dnalepa04/Pour-Pal/README.md

Hello! This is a repository for a project my friends (Adam Slamani & Carter Hill) and I worked on in our Microcontrollers class. I suggest looking at the presentation PDF to get a better understanding of the project overview! If you would like a more in depth overview please look at the report written for this project.

Access_Point
This is the final release of the code that is fully commeneted and ready for use with the drink dispenser

access_point_v1
This version for the code was the initial draft of the website

access_point_v2
This version added the motor driver functionality

access_point_v3
This version added the dispensing functionality and custom cocktails

access_point_v4
This version added the true flow rate for the pumps

access_point_v5
This version added a feature to expell all of the water out of the tubes after it is done.

access_point_v6
This version added flash functionality so that the custom cocktails would be saved after the system is powered off.

wifi_connect_ESP32_enterpirse
This was a code that allowed the ESP32 to connect to the UVM WiFi
