dnalepa04/Pour-Pal/Pour Pal Presi.pdf

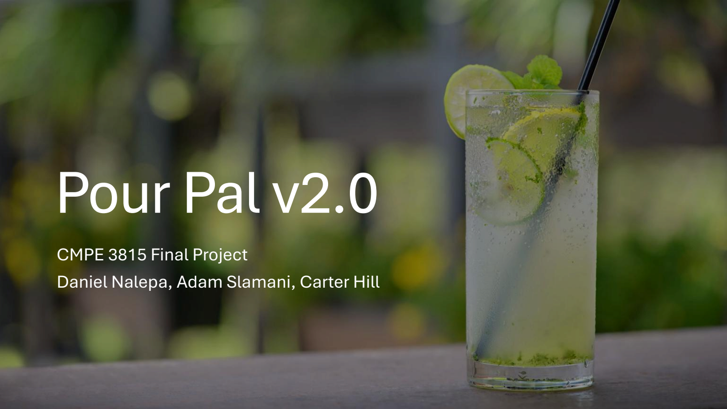
[picture p16: page 1]

# Pour Pal v2.0

### CMPE 3815 Final Project Daniel Nalepa, Adam Slamani, Carter Hill

# Agenda

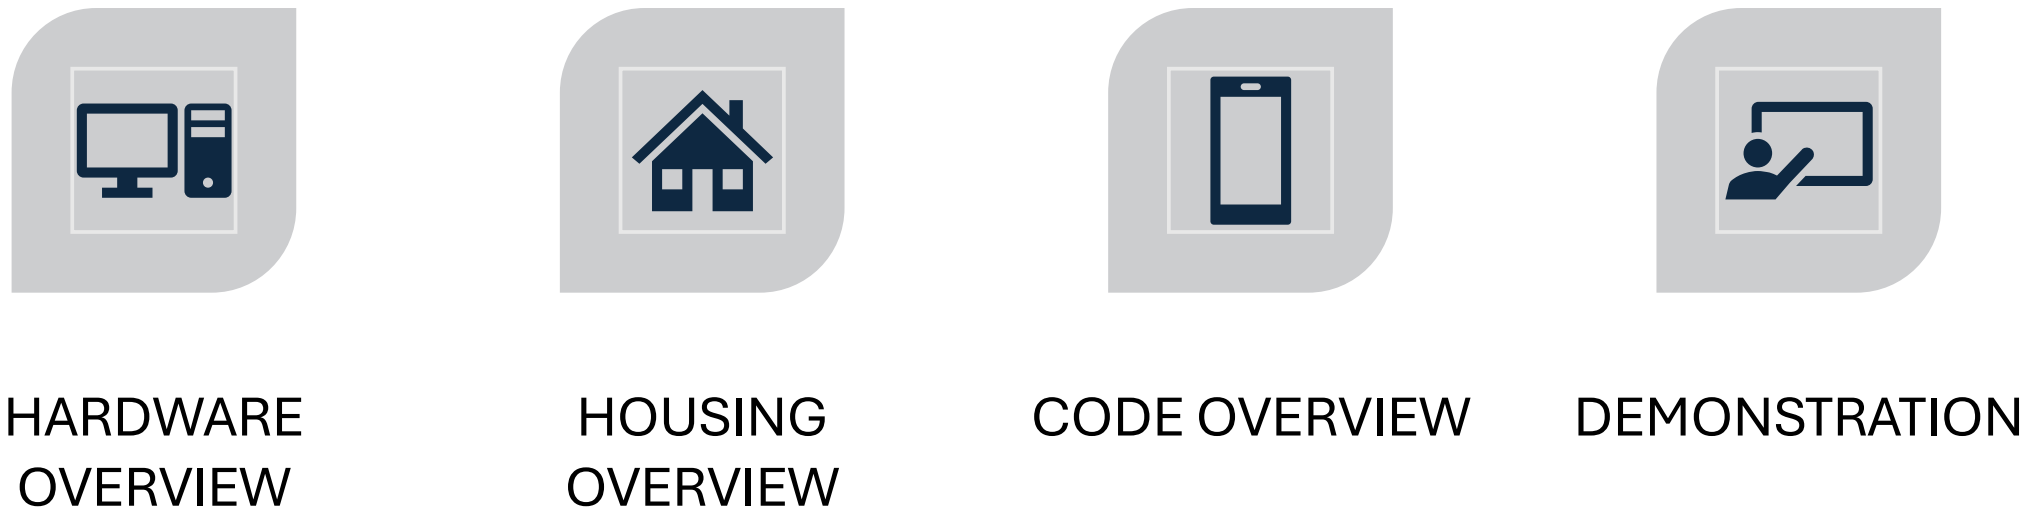
[picture p17: figure]
HARDWARE OVERVIEW; HOUSING OVERVIEW; CODE OVERVIEW; DEMONSTRATION
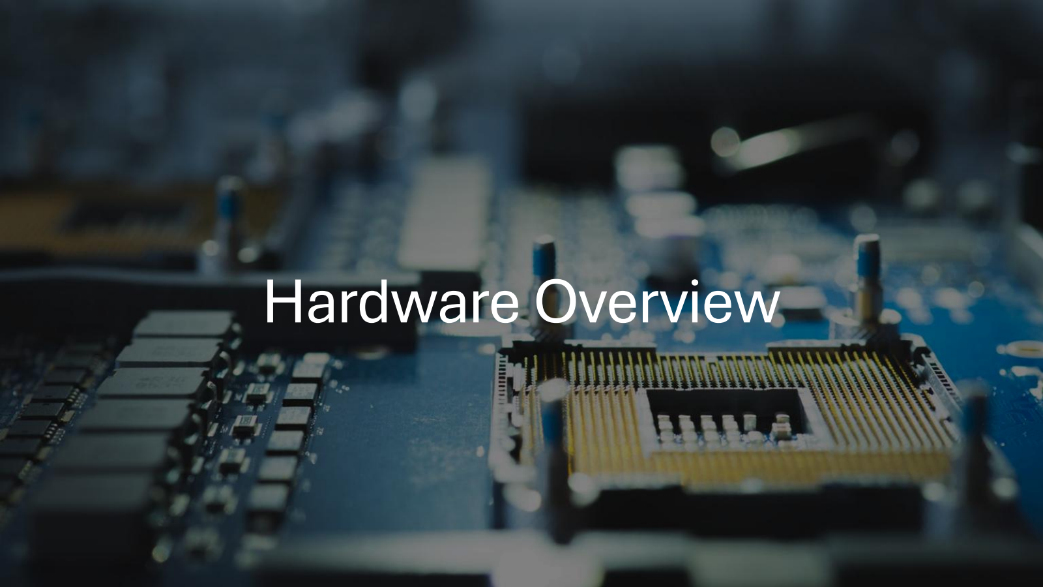
[picture p18: page 3]

# Hardware Overview

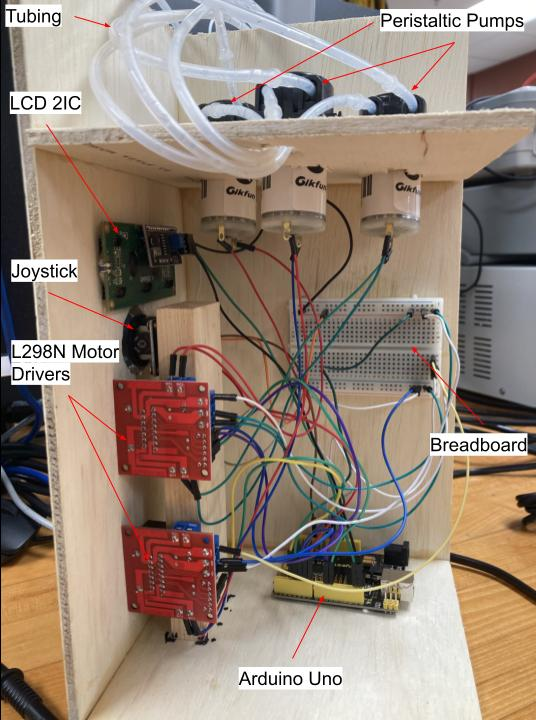
[picture p19: figure]

# Previous Design

Limitations
- Only three 100 ml/min pumps
- Motors not at 12VDC so slower than 100 ml
- Joystick controls everything
- Exposed Components
- Ugly housing and prone to spillage

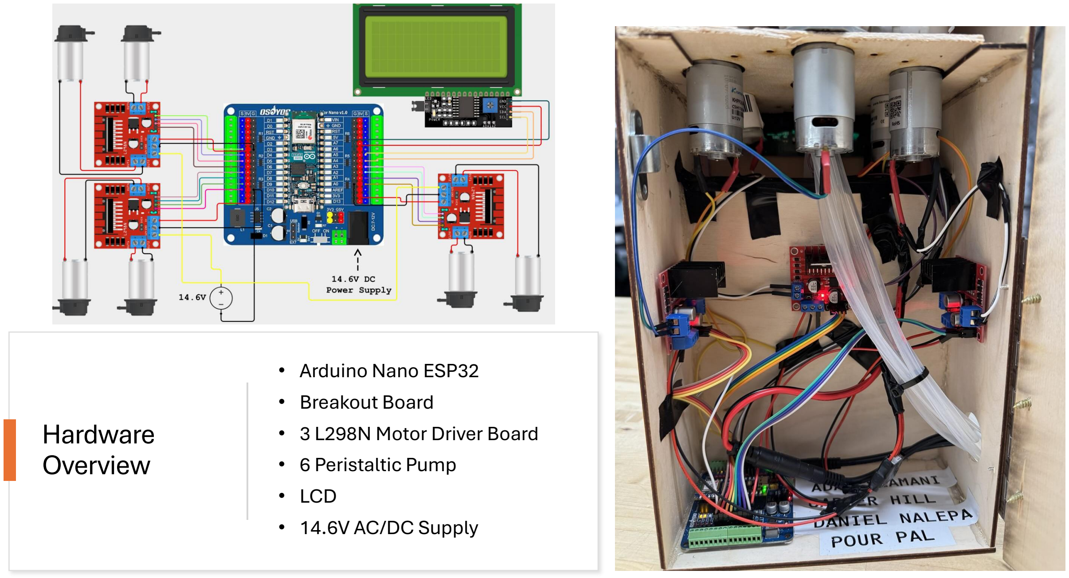
[picture p20: page 5]

### Hardware Overview

- Arduino Nano ESP32
- Breakout Board
- 3 L298N Motor Driver Board
- 6 Peristaltic Pump
- LCD
- 14.6V AC/DC Supply

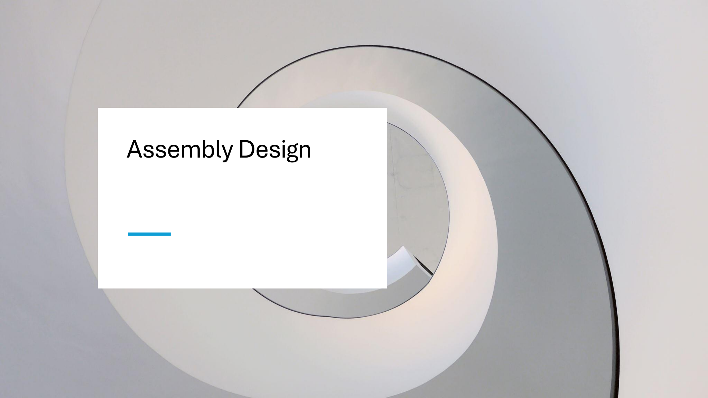
[picture p21: page 6]

# Assembly Design

## Housing Overview

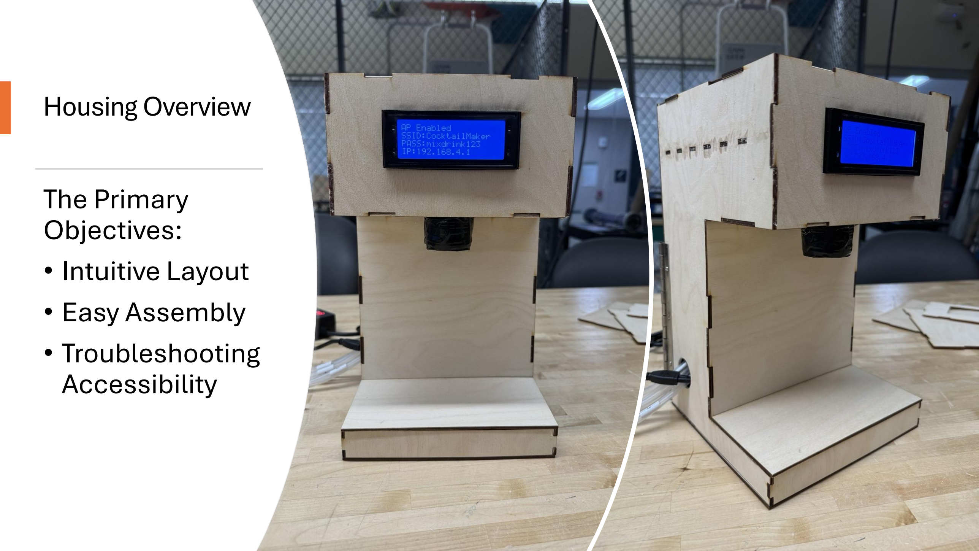
[picture p22: page 7]

## The Primary Objectives: - Intuitive Layout - Easy Assembly - Troubleshooting Accessibility

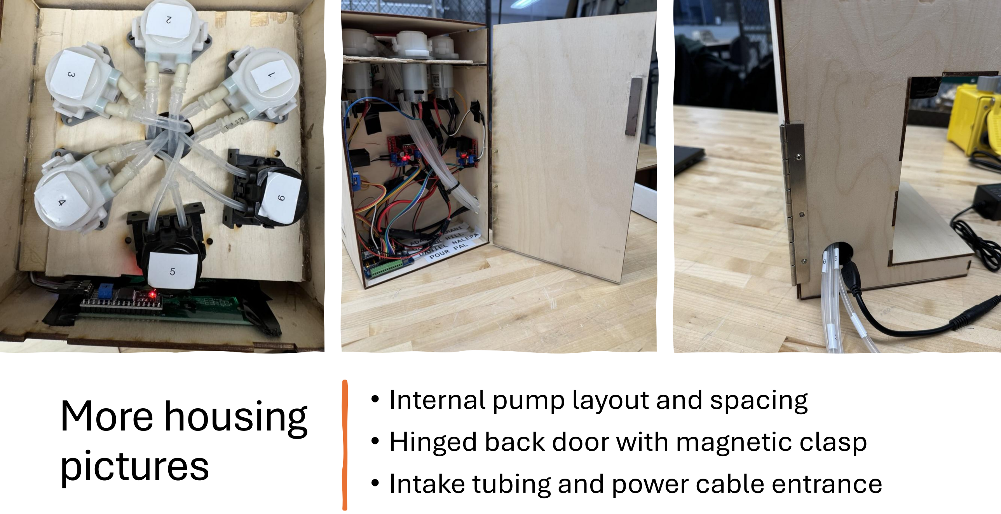
[picture p23: page 8]

# More housing pictures

## - Internal pump layout and spacing - Hinged back door with magnetic clasp - Intake tubing and power cable entrance

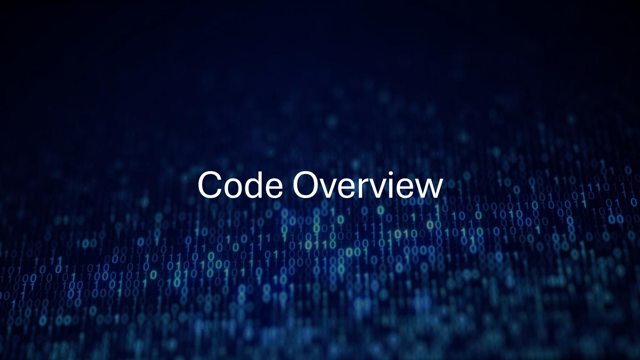
[picture p24: page 9]

# Code Overview

# Hardware Control

### - Helper functions that control motor behavior - Dispenses by converting from mL→run-time - Includes ESP32 flash memory with JSON & Preferences library - Cocktail names (max 10), ingredient name, and pump volumes

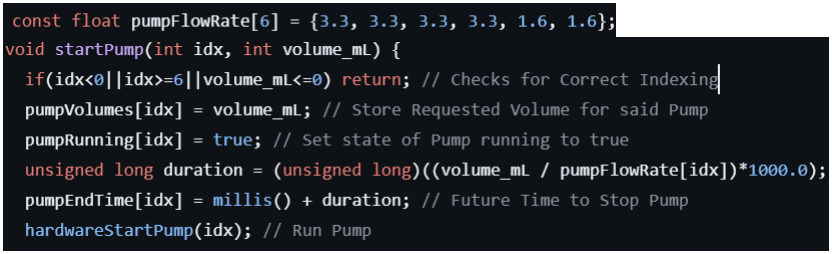
[picture p25: figure]

# Wi-Fi Access Point & Web Server

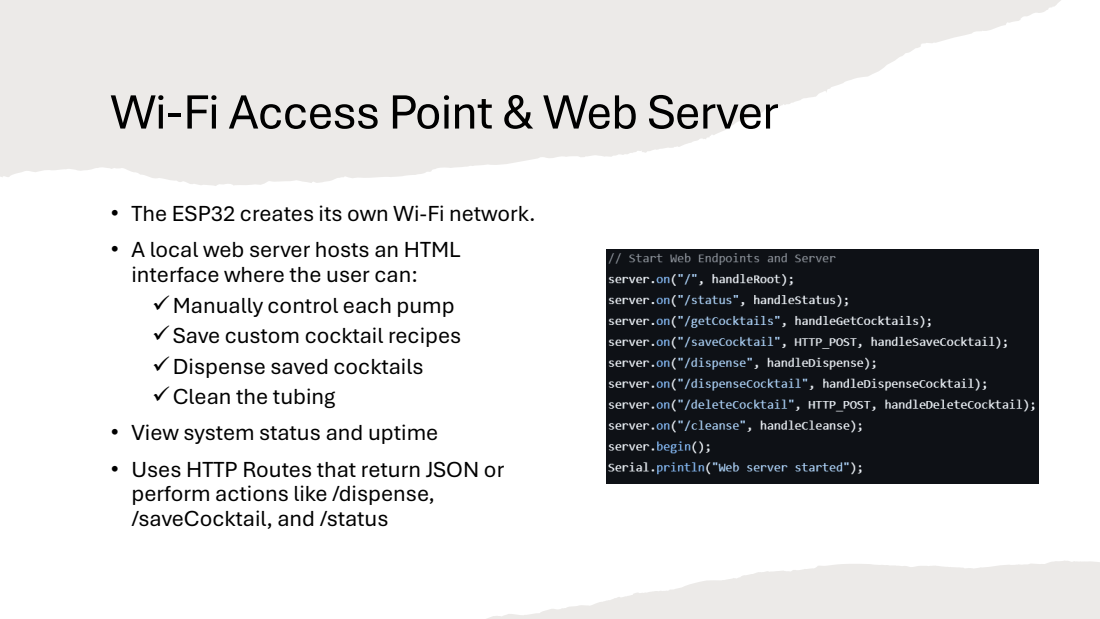
[picture p26: page 11]

• The ESP32 creates its own Wi-Fi network.
• A local web server hosts an HTML
interface where the user can:
✓Manually control each pump
✓Save custom cocktail recipes
✓Dispense saved cocktails
✓Clean the tubing
• View system status and uptime
• Uses HTTP Routes that return JSON or
perform actions like /dispense,
/saveCocktail, and /status

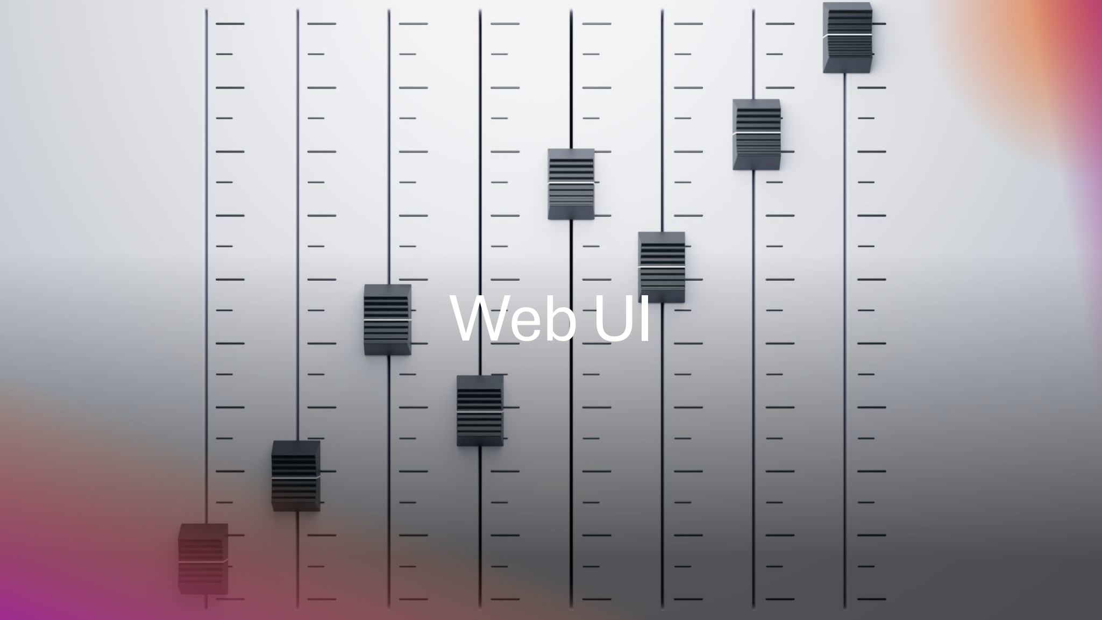
[picture p27: page 12]

# Web UI

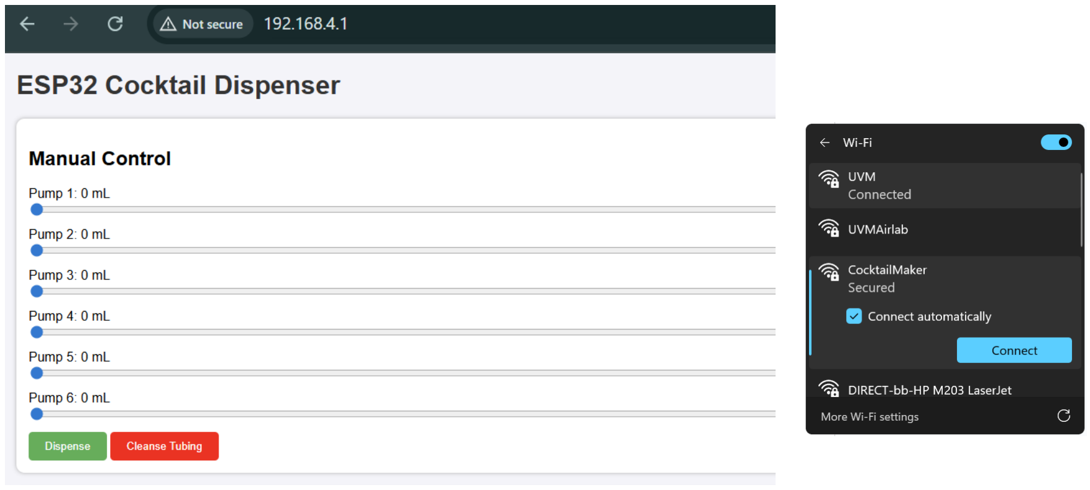
[picture p28: page 13]
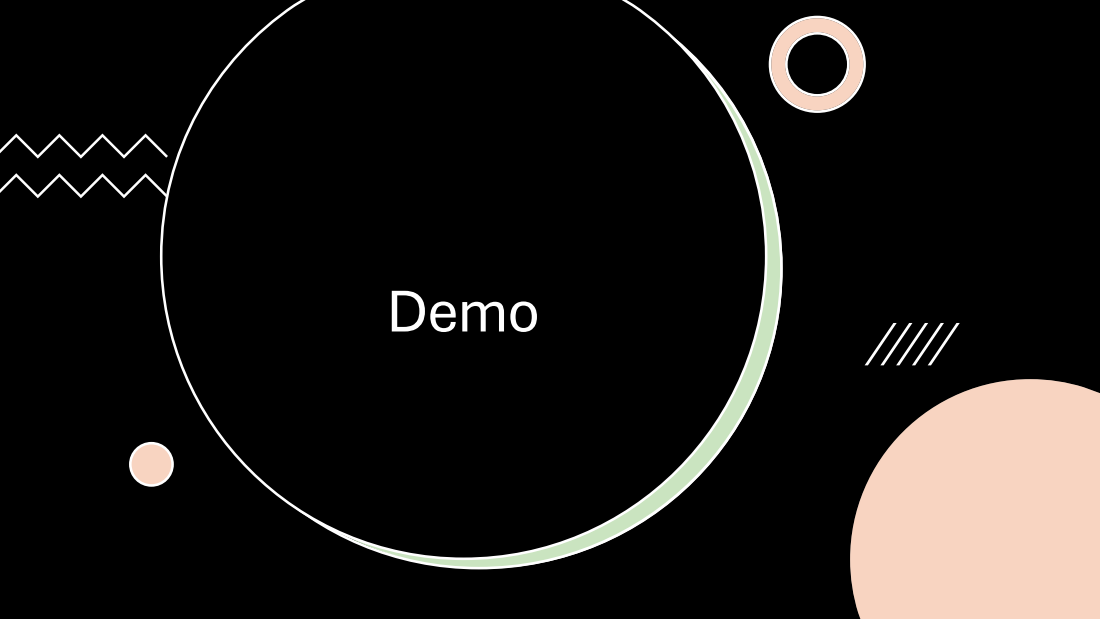
[picture p29: page 15]
Demo
